ubicomplab/AuraRing/README.md

# AuraRing
Precise Electromagnetic Finger Tracking

AuraRing is 5-DoF electromagnetic tracker that enables precise, accurate, and fine-grained finger tracking for AR, VR and wearable applications.
