ubicomplab/AuraRing/pcb/wristBand_rx/ring_rx_v3_controller/ring_rx_v3_controller.xls

Line # | Name | Description | Designator | Quantity | Value | Manufacturer 1 | Manufacturer Part Number 1 | Manufacturer Lifecycle 1 | Supplier 1 | Supplier Part Number 1 | Supplier Unit Price 1 | Supplier Subtotal 1
 | Cap | Ceramic Capacitor (Surface Mount) | C3_c11, C3_c12, C3_c21, C3_c22, C3_c31, C3_c32 | 6 | 56nF | KEMET | C0402C563K9RACTU | Volume Production | Arrow | C0402C563K9RACTU | 0.3515 | 2.11
 | Cap | Ceramic Capacitor (Surface Mount) | C4_c11, C4_c12, C4_c21, C4_c22, C4_c31, C4_c32, C18_c11, C18_c12, C18_c21, C18_c22, C18_c31, C18_c32 | 12 | 10nF | Samsung | CL05B103KB5NNNC | Volume Production | Digi-Key | 1276-1028-1-ND | 0.024 | 0.288
 | Cap | Ceramic Capacitor (Surface Mount) | C5_c11, C5_c12, C5_c21, C5_c22, C5_c31, C5_c32, C8_c11, C8_c12, C8_c21, C8_c22, C8_c31, C8_c32, C16_c11, C16_c12, C16_c21, C16_c22, C16_c31, C16_c32 | 18 | 3.3nF | Yageo | CC0402JRX7R9BB332 | Volume Production | Mouser | 603-CC402JRX7R9BB332 | 0.028 | 0.504
 | Cap | Ceramic Capacitor (Surface Mount) | C9 | 1 | 1nF | Yageo | CC0402JRX7R9BB102 | Volume Production | Arrow | CC0402JRX7R9BB102 | 0.0102 | 0.0102
 | Cap | Ceramic Capacitor (Surface Mount) | C10, C13, C15, CU1, CU3, CU4_c11, CU4_c12, CU4_c21, CU4_c22, CU4_c31, CU4_c32 | 11 | 0.1uF | Samsung | CL05B104KO5NNNC | Volume Production | Digi-Key | 1276-1001-6-ND | 0.024 | 0.264
 | Cap | Ceramic Capacitor (Surface Mount) | C11, C12, C14 | 3 | 1uF | Samsung | CL05A105KP5NNNC | Volume Production | Arrow | CL05A105KP5NNNC | 0.0596 | 0.1788
 | Cap | Ceramic Capacitor (Surface Mount) | C17 | 1 | 470nF | Samsung | CL05A474KP5NNNC | Volume Production | Digi-Key | 1276-1173-6-ND | 0.1 | 0.1
 | Cap | Ceramic Capacitor (Surface Mount) | CU1-1, CU3-1 | 2 | 10uF | Murata | GRM155R60G106ME44D | Volume Production | Digi-Key | 490-10693-6-ND | 0.21 | 0.42
 | Cap | Ceramic Capacitor (Surface Mount) | CU?_U_coil_processing1, CU?_U_coil_processing2 | 2 | 2.2uF
 | TLMS1100-GS08 | LED, RED, 2.1 V, -40 to 100 degC, 2-Pin SMD (0603), RoHS, Tape and Reel | DS1, DS2 | 2 |  | Vishay | TLMS1100-GS08 | Volume Production | Mouser | 782-TLMS1100 | 0.4 | 0.8
 | 503480-1000 | 0.5 mm Pitch Easy-On(TM) BackFlip(TM) Type FPC Connector, 1.0 mm Mated Height, Right Angle, SMT, Dual Contact, 10 Circuits, -40 to 85 degC, ELV and RoHS Compliant, Tape and Reel | J1_U_coil_processing1, J1_U_coil_processing2 | 2 |  | Molex | 503480-1000 | Volume Production | Mouser | 538-503480-1000 | 0.84 | 1.68
 | MHDR1X4 | Header, 4-Pin | JTAG1 | 1 |  | Mill-Max | 851-43-004-10-001000 | Volume Production | Digi-Key | ED90528-ND | 1.43 | 1.43
 | Header 6H | Header, 6-Pin, Right Angle | P2 | 1 |  | Harwin | M20-9710646 | Volume Production | Digi-Key | 952-2372-ND | 0.26 | 0.26
 | Res | Chip Resistor (Surface Mount) | R3_c11, R3_c12, R3_c21, R3_c22, R3_c31, R3_c32, R6_c11, R6_c12, R6_c21, R6_c22, R6_c31, R6_c32 | 12 | 2k | Susumu | RR0510P-202-D | Volume Production | Arrow | RR0510P-202-D | 0.0409 | 0.4908
 | Res | Chip Resistor (Surface Mount) | R4_c11, R4_c12, R4_c21, R4_c22, R4_c31, R4_c32, R7_c11, R7_c12, R7_c21, R7_c22, R7_c31, R7_c32 | 12 | 1.33k | Yageo | RT0402BRD071K33L | Volume Production | Arrow | RT0402BRD071K33L | 0.2138 | 2.57
 | Res | Chip Resistor (Surface Mount) | R5 | 1 | 47k | Yageo | RC0402FR-0747KL | Volume Production | Arrow | RC0402FR-0747KL | 0.0011 | 0.0011
 | Res | Chip Resistor (Surface Mount) | R8_c11, R8_c12, R8_c21, R8_c22, R8_c31, R8_c32, R9_c11, R9_c12, R9_c21, R9_c22, R9_c31, R9_c32 | 12 | 3.92k | Stackpole Electronics | RMCF0402FT3K92 | Volume Production | Digi-Key | RMCF0402FT3K92DKR-ND | 0.016 | 0.192
 | Res | Chip Resistor (Surface Mount) | R10_c11, R10_c12, R10_c21, R10_c22, R10_c31, R10_c32, R11_c11, R11_c12, R11_c21, R11_c22, R11_c31, R11_c32 | 12 | 30.1 | Yageo | RT0402BRE0730R1L | Volume Production | Digi-Key | YAG4373DKR-ND | 0.303 | 3.64
 | Res | Chip Resistor (Surface Mount) | Rled1, Rled2 | 2 | 1k | Susumu | RR0510P-102-D | Volume Production | Arrow | RR0510P-102-D | 0.0943 | 0.1886
 | Res | Chip Resistor (Surface Mount) | Rr1 | 1 | 0 | Stackpole Electronics | RMCF0402ZT0R00 | Volume Production | Digi-Key | RMCF0402ZT0R00DKR-ND | 0.1 | 0.1
 | Res | Chip Resistor (Surface Mount) | Rr2 | 1 | DNP
 | MSP430FR2422 | MSP430FR2422 Mixed-Signal Microcontroller | U1 | 1 |  | Texas Instruments | MSP430FR2422IPW16 |  | Digi-Key | 296-48357-ND | 1.84 | 1.84
 | AD7265BCPZ-REEL7 | 1Dual 12-Bit SAR Analog-to-Digital Converter with Serial, SPI Interface, 1MSPS, -40 to +125 degC, CP-32-2, Pb-Free, Reel | U2 | 1 |  | Analog Devices | AD7265BCPZ-REEL7 | Volume Production | Arrow | AD7265BCPZ-REEL7 | 9.21 | 9.21
 | LTC6363 |  | U4_c11, U4_c12, U4_c21, U4_c22, U4_c31, U4_c32 | 6 |  | Analog Devices / Linear Technology | LTC6363IMS8#TRPBF | Not Recommended for New Design | Digi-Key | LTC6363IMS8#TRPBFDKR-ND | 6.2 | 37.2
 | ADA4084-1ARJZ-R7 | 30 V, 8 MHz, Low Bias Current, Single-Supply, RRO, Precision Op Amps | U9 | 1 |  |  |  |  | Digi-Key | ADA4084-1ARJZ-R7CT-ND
 | TPS70933 | 3.3V Ultra low power Voltage Regulator | U10 | 1 |  | Texas Instruments | TPS70933DBVT | Volume Production | Digi-Key | 296-39474-1-ND | 1.34 | 1.34
 | ADR3412ARJZ-R2 | Micropower, High Accuracy Voltage Reference, 1.2 V Output, 2.3 to 5.5 V Supply, Industrial, 6-pin SOT23 (RJ-6), Reel | U11 | 1 |  | Analog Devices | ADR3412ARJZ-R2 | Volume Production | Arrow | ADR3412ARJZ-R2 | 3.67 | 3.67
