ubicomplab/AuraRing/pcb/wristBand_rx/ring_rx_v3_sensor/ring_rx_v3_sensor.xls

Line # | Name | Description | Designator | Quantity | Value | Manufacturer 1 | Manufacturer Part Number 1 | Manufacturer Lifecycle 1 | Supplier 1 | Supplier Part Number 1 | Supplier Unit Price 1 | Supplier Subtotal 1
 | Cap | Ceramic Capacitor (Surface Mount) | C1_c1, C1_c2, C1_c3 | 3 | 2200pF | KEMET | C0402C222J3GACTU | Volume Production | Newark | 94M5623 | 0.563 | 1.69
 | Cap | Ceramic Capacitor (Surface Mount) | C2_c1, C2_c2, C2_c3 | 3 | 150pF | Kyocera AVX | 04025A151FAT2A | Volume Production | Digi-Key | 478-10089-6-ND | 0.36 | 1.08
 | Cap | Ceramic Capacitor (Surface Mount) | C6_c1, C6_c2, C6_c3, C7_c1, C7_c2, C7_c3 | 6 | 1nF | Yageo | CC0402JRX7R9BB102 | Volume Production | Arrow | CC0402JRX7R9BB102 | 0.0102 | 0.0612
 | Cap | Ceramic Capacitor (Surface Mount) | Cfilt1_c1, Cfilt1_c2, Cfilt1_c3 | 3 | 470pF | Samsung | CL05B471JB5NNNC | Volume Production | Arrow | CL05B471JB5NNNC | 0.0092 | 0.0276
 | Cap | Ceramic Capacitor (Surface Mount) | CU2_c1, CU2_c2, CU2_c3 | 3 | 0.1uF | Samsung | CL05B104KO5NNNC | Volume Production | Digi-Key | 1276-1001-6-ND | 0.024 | 0.24
 | 503480-1000 | 0.5 mm Pitch Easy-On(TM) BackFlip(TM) Type FPC Connector, 1.0 mm Mated Height, Right Angle, SMT, Dual Contact, 10 Circuits, -40 to 85 degC, ELV and RoHS Compliant, Tape and Reel | J1 | 1 |  | Molex | 503480-1000 | Volume Production | Mouser | 538-503480-1000 | 0.84 | 0.84
 | 3DC15 |  | L1 | 1 |  | Grupo Premo | 3DC15-1000J | Manual Solution | Grupo Premo | 3DC15-1000J | 5.73 | 5.73
 | Res | Chip Resistor (Surface Mount) | R1_c1, R1_c2, R1_c3, R2_c1, R2_c2, R2_c3 | 6 | 332k | Stackpole Electronics | RMCF0402FT332K | Volume Production | Digi-Key | RMCF0402FT332KDKR-ND | 0.016 | 0.16
 | SMS7630-040 |  | Rd1_c1, Rd1_c2, Rd1_c3, Rd2_c1, Rd2_c2, Rd2_c3, Rd3_c1, Rd3_c2, Rd3_c3, Rd4_c1, Rd4_c2, Rd4_c3 | 12 |  | Skyworks Solutions | SMS7630-040LF | Volume Production | Mouser | 873-SMS7630-040LF | 0.449 | 5.39
 | Res | Chip Resistor (Surface Mount) | Rg1_c1, Rg1_c2, Rg1_c3 | 3 | 100 | TE Connectivity | RN73C1E100RBTDF | Volume Production | Mouser | 279-RN73C1E100RBTDF | 0.9 | 2.7
 | INA826AIDRGT | Precision, 200-uA Supply Current, 36-V Supply Instrumentation Amplifier, -40 to 125 degC, 8-pin SON (DRG8), Green (RoHS & no Sb/Br) | U2_c1, U2_c2, U2_c3 | 3 |  | Texas Instruments | INA826AIDRGT | Volume Production | Arrow | INA826AIDRGT | 2.74 | 8.21
