ubicomplab/AuraRing/cad/ring/ring_20.STL

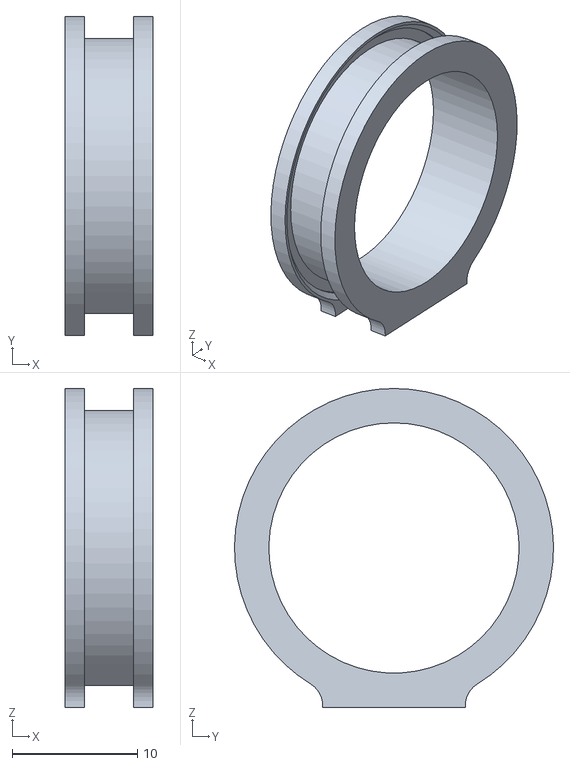
[picture p1: CAD file, 2020-01-06]
cad/ring/ring_20.STL
7.00 x 25.5 x 25.5
