ubicomplab/AuraRing/cad/wristband/wristband.STL

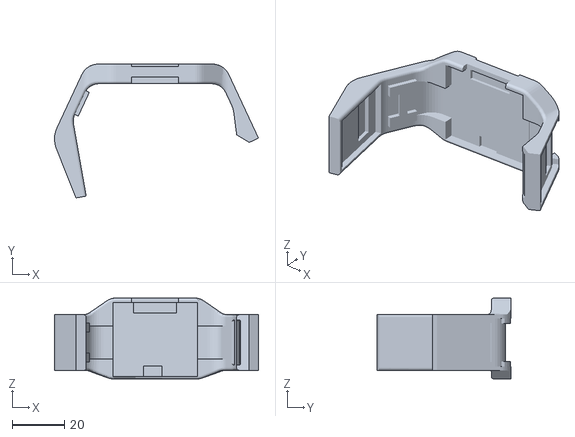
[picture p2: CAD file, 2020-01-06]
cad/wristband/wristband.STL
78.1 x 51.2 x 31.0
