ubicomplab/AuraRing/pcb/wristBand_rx/ring_rx_v3_sensor/ring_rx_v3_sensor.step

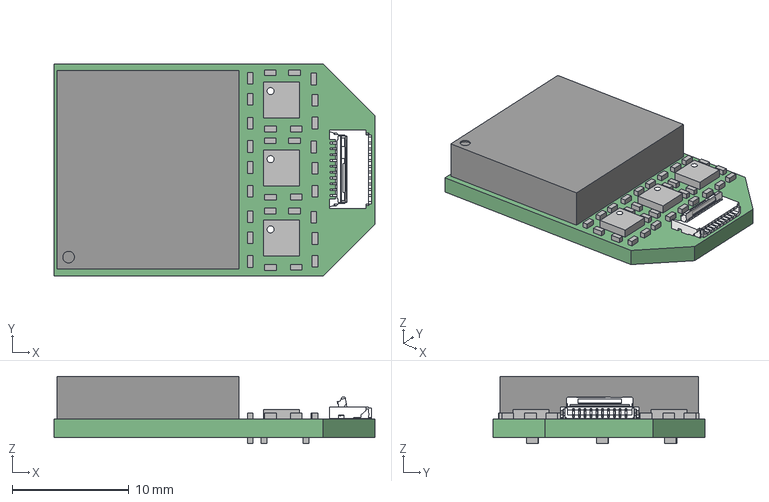
[picture p3: CAD file, 2019-12-18]
pcb/wristBand_rx/ring_rx_v3_sensor/ring_rx_v3_sensor.step
27.5 x 18.2 x 5.75 mm
