ubicomplab/AuraRing/cad/ring/tracking_adapter_22.STL

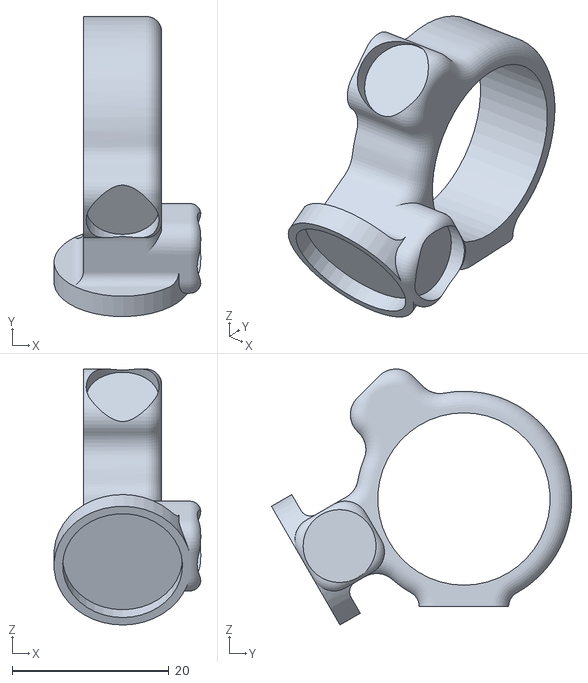
[picture p4: CAD file, 2020-01-06]
cad/ring/tracking_adapter_22.STL
18.7 x 38.3 x 32.7
