ubicomplab/AuraRing/cad/wristband/tracking_adapter.STL

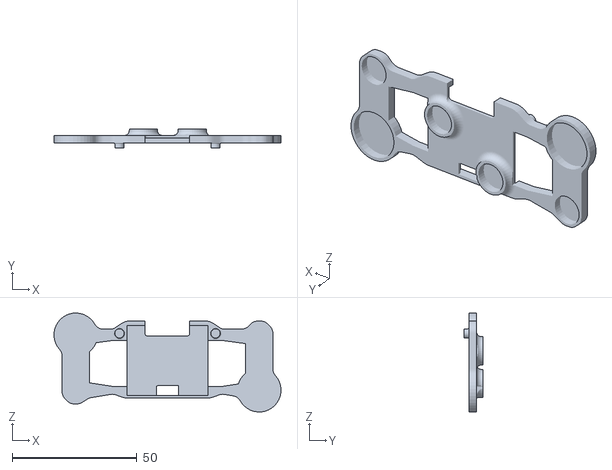
[picture p5: CAD file, 2020-01-06]
cad/wristband/tracking_adapter.STL
91.1 x 7.50 x 39.7
