ubicomplab/AuraRing/cad/ring/ring_inset_22.STL

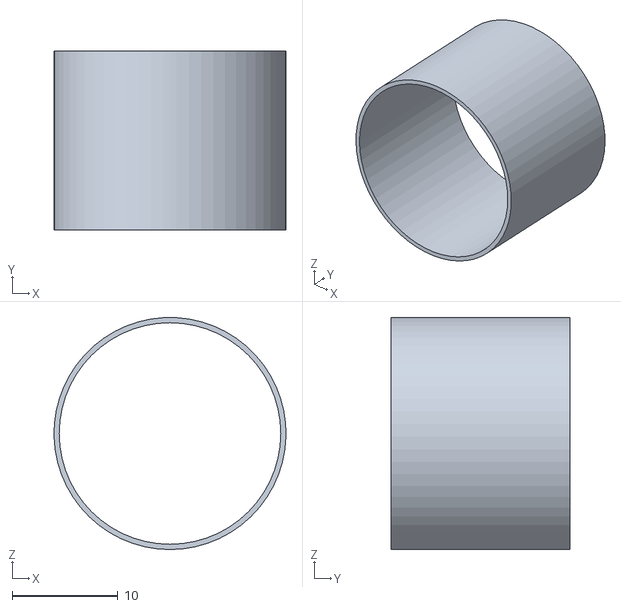
[picture p6: CAD file, 2020-01-06]
cad/ring/ring_inset_22.STL
22.0 x 17.0 x 22.0
