ubicomplab/AuraRing/cad/ring/ring_22.STL

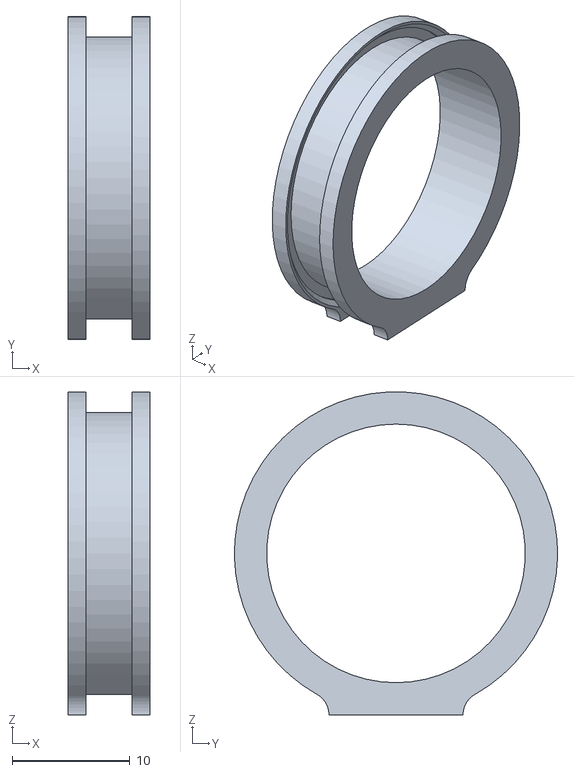
[picture p7: CAD file, 2020-01-06]
cad/ring/ring_22.STL
7.00 x 27.5 x 27.5
