ubicomplab/AuraRing/cad/ring/tracking_adapter_20.STL

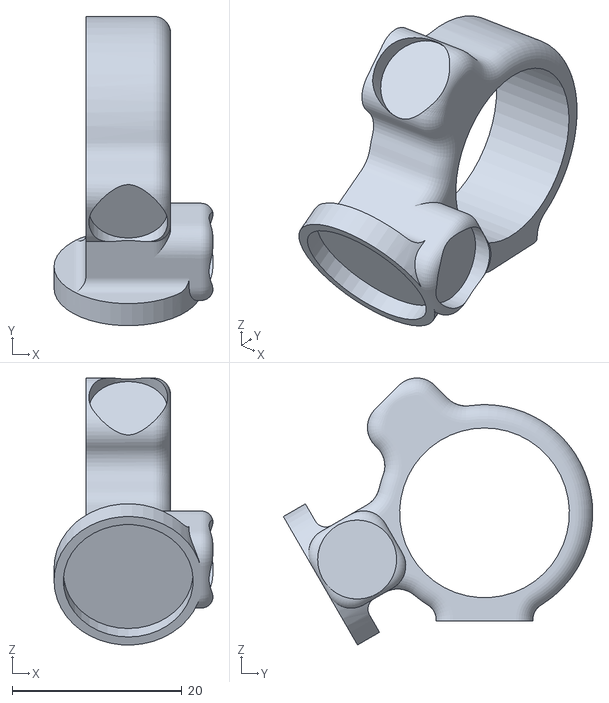
[picture p8: CAD file, 2020-01-06]
cad/ring/tracking_adapter_20.STL
18.7 x 36.5 x 31.5
