ubicomplab/AuraRing/cad/ring/ring_inset_20.STL

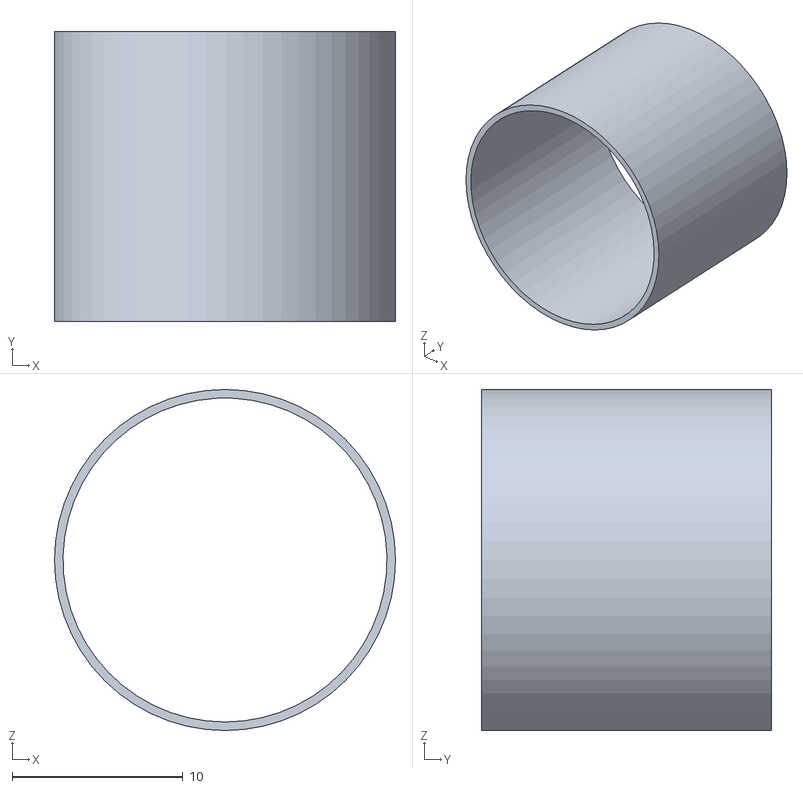
[picture p9: CAD file, 2020-01-06]
cad/ring/ring_inset_20.STL
20.0 x 17.0 x 20.0
