ubicomplab/AuraRing/(threads)

Thread 2 (2023-02-15):

specific Version of dependencis

Myzhencai, 2023-02-15:
Hi we just have make up the hardware and we have tried to compile the code of mag-inverse but we failed it seems that the version of the Eigen and the Ceres is wrong ,could you please sharing the specific Version of these dependences,thanks:-)
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

Myzhencai, 2023-02-15:
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
