ubicomplab/AuraRing/pcb/ring_tx/ring_v3.pdf

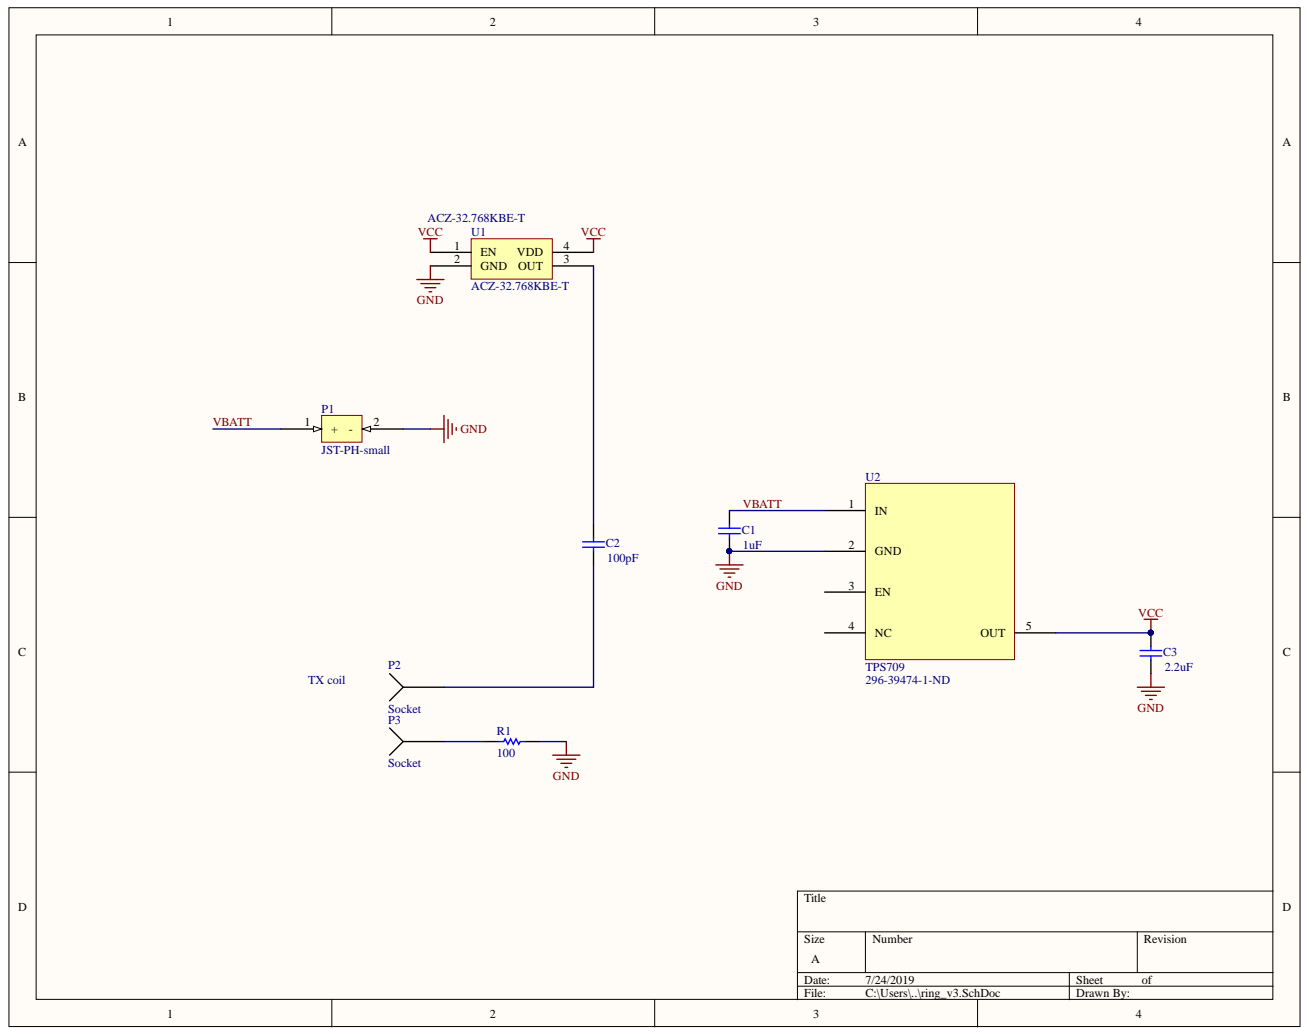
[picture p10: page 1]

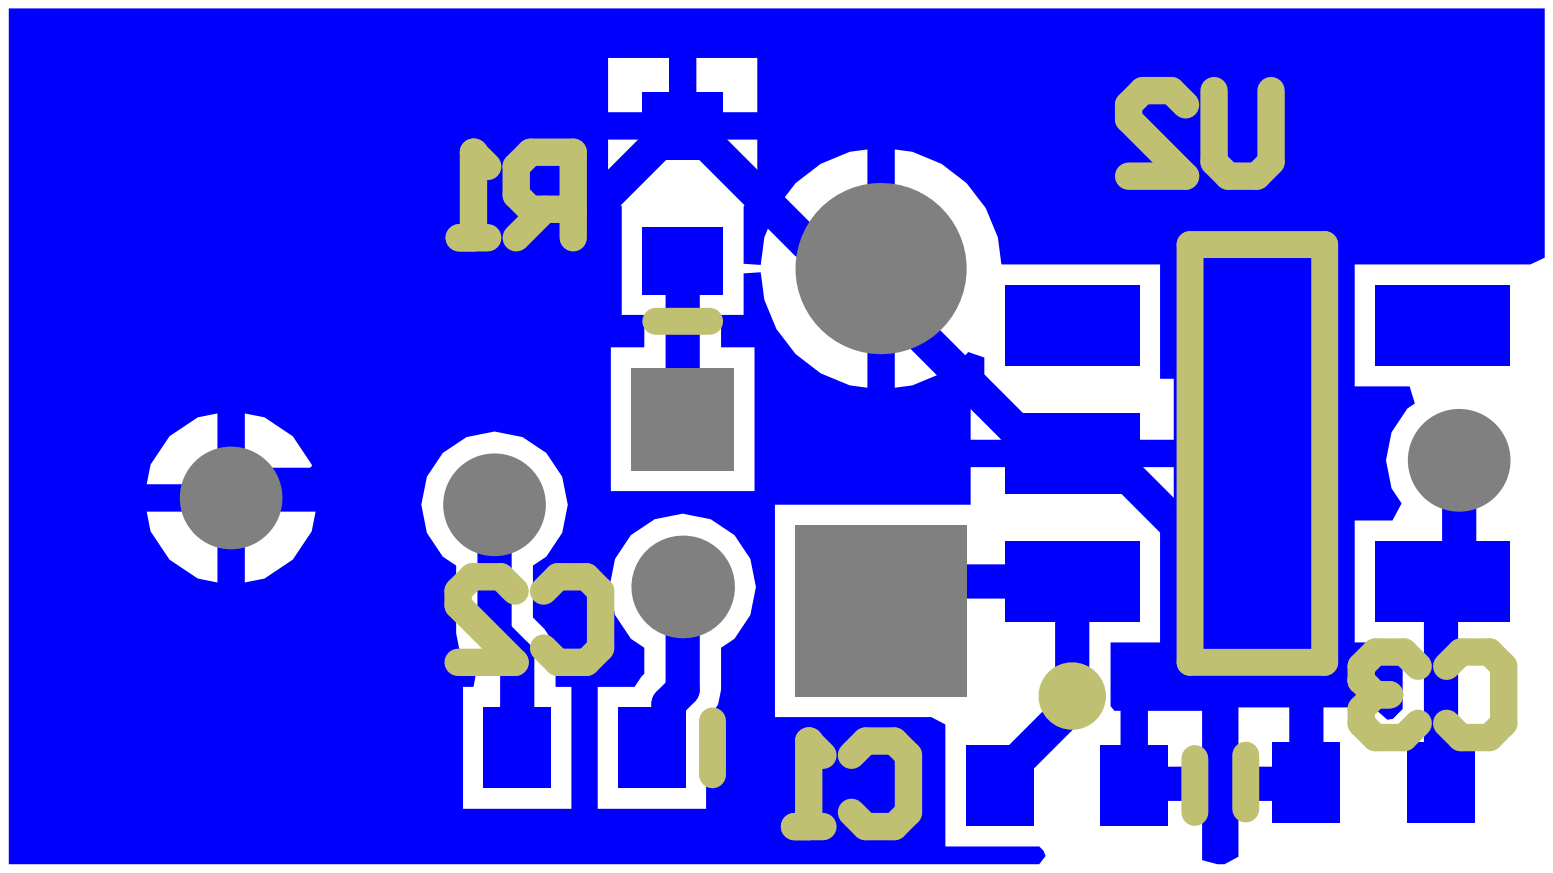
[picture p11: page 2]

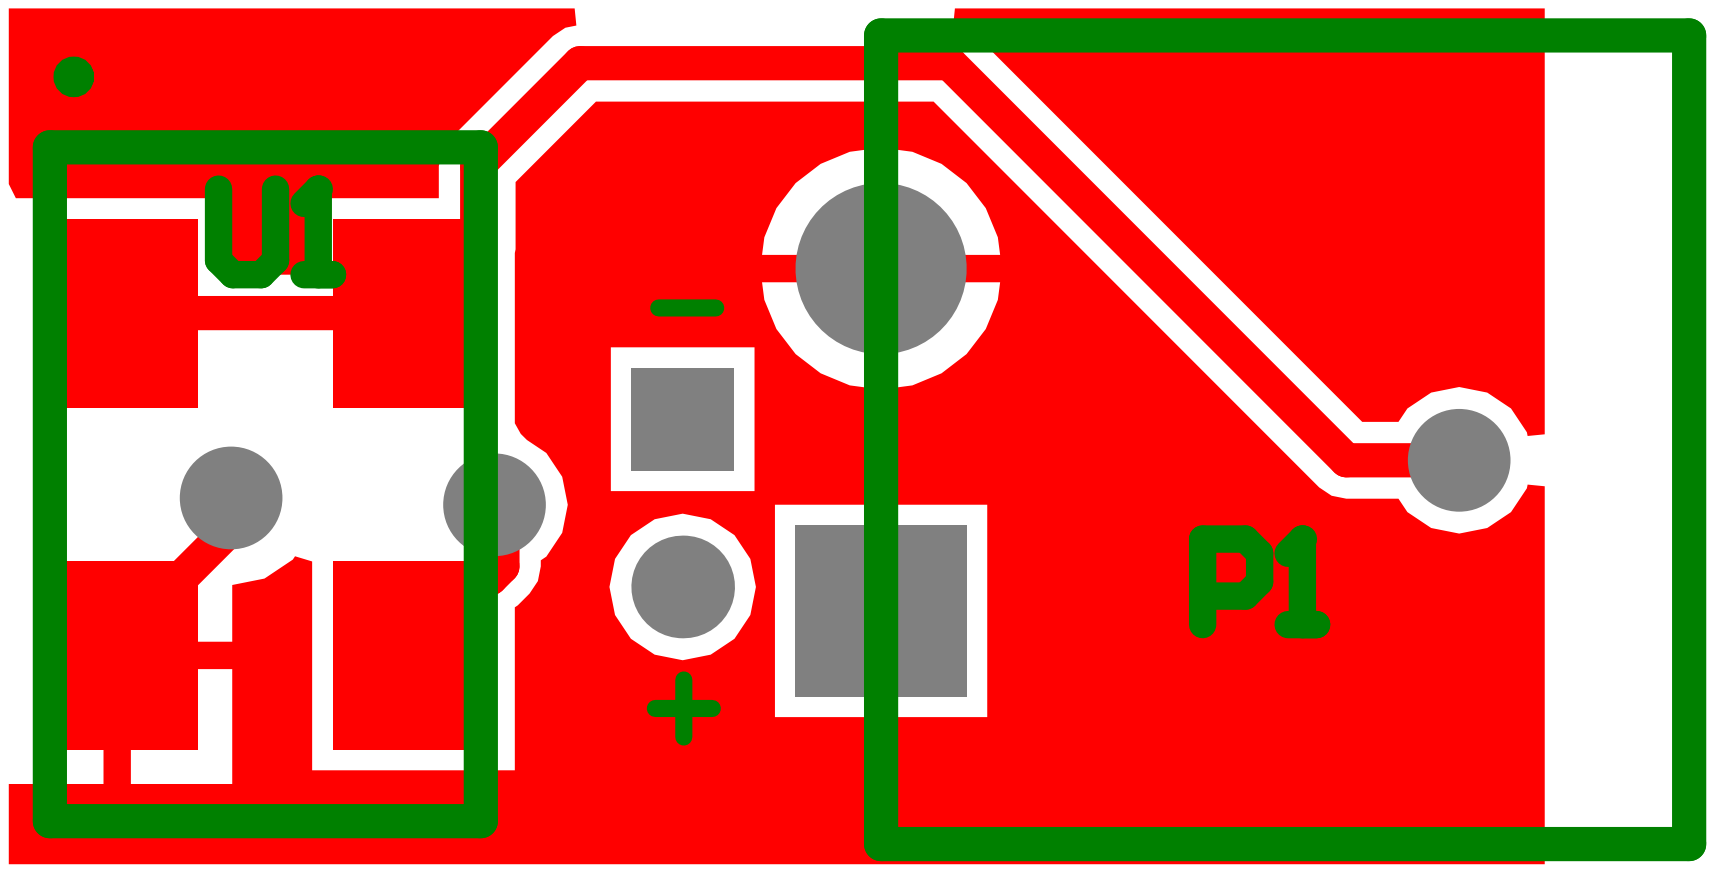
[picture p12: page 3]

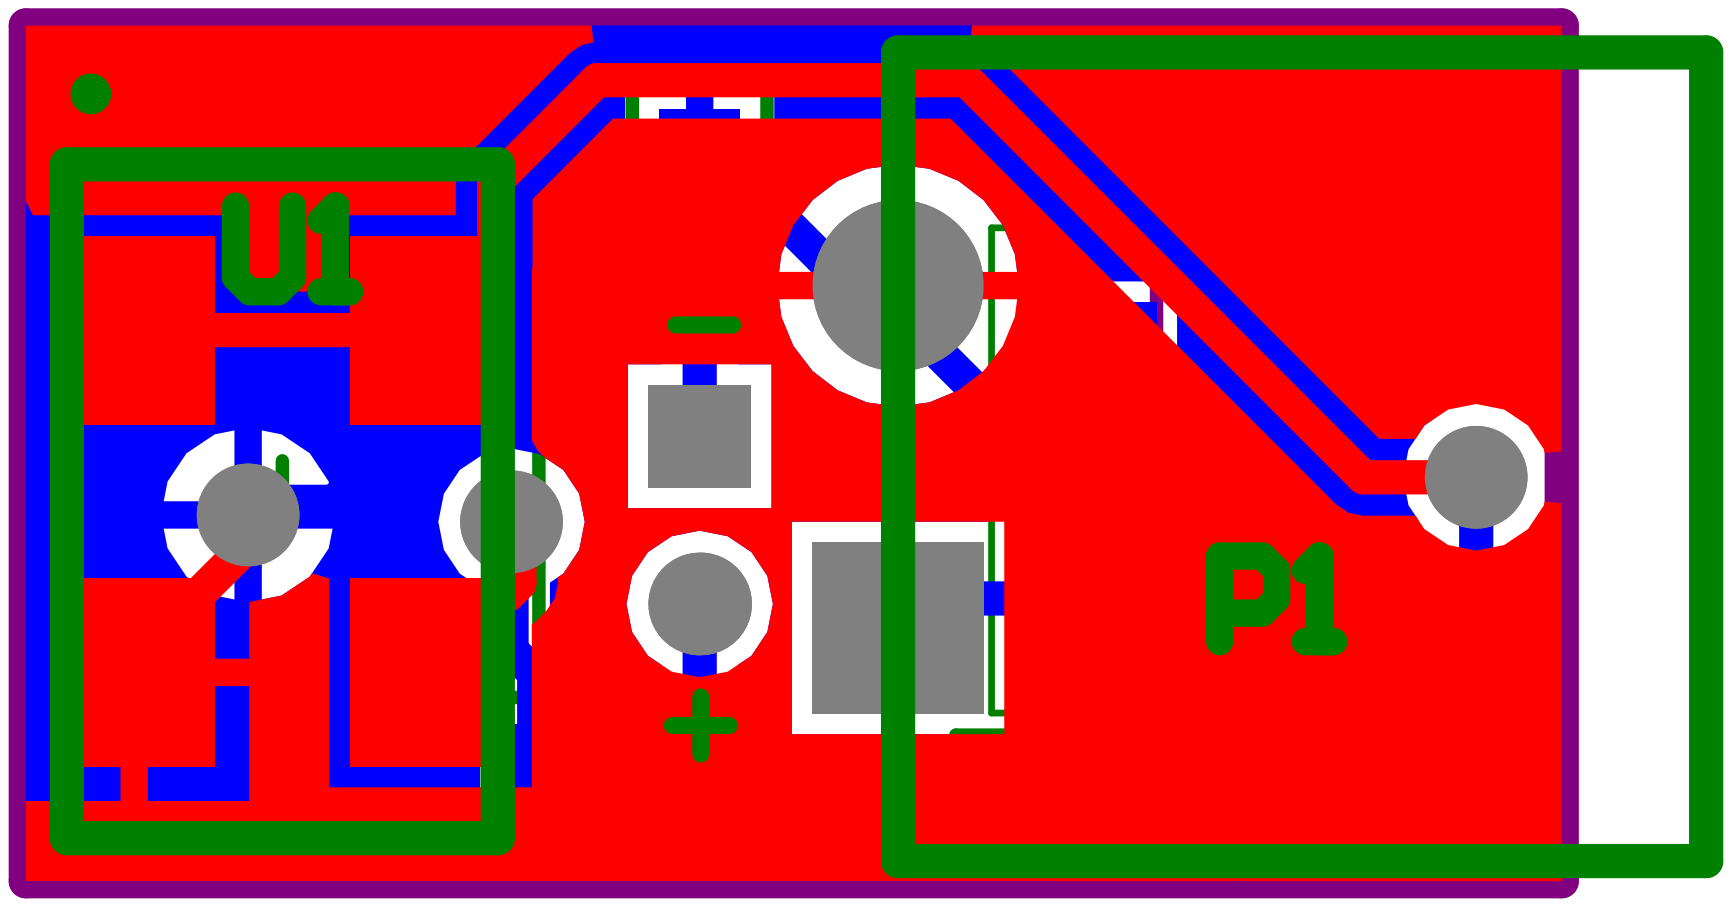
[picture p13: page 4]

Comment | Description | Designator | Footprint | LibRef | Quantity
Cap | Ceramic Capacitor (Surface Mount) C1 | | 402 | Cap | 1
Cap | Ceramic Capacitor (Surface Mount) C2 | | 402 | Cap | 1
Cap | Ceramic Capacitor (Surface Mount) C3 | | 402 | Cap | 1
JST-PH-small | | P1 | JST-PH-small | JST-PH-small | 1
Socket | | P2 | socket | Socket | 1
Socket | | P3 | socket | Socket | 1
Res | Chip Resistor (Surface Mount) R1 | | 402 | Res | 1
ACZ-32.768KBE-T | 32.768kHz XO (Standard) CMOS Oscillator 3.3V Enable/Disable 4-SMD, No Lead U1 | | ACZ-32.768KBE-T | ACZ-32.768KBE-T | 1
TPS709 | 3.3V Ultra low power Voltage Regulator U2 | | SOT95P280X145-5N | TPS70933 | 1
