ubicomplab/AuraRing/pcb/wristBand_rx/ring_rx_v3/assmblyDrawing.pdf

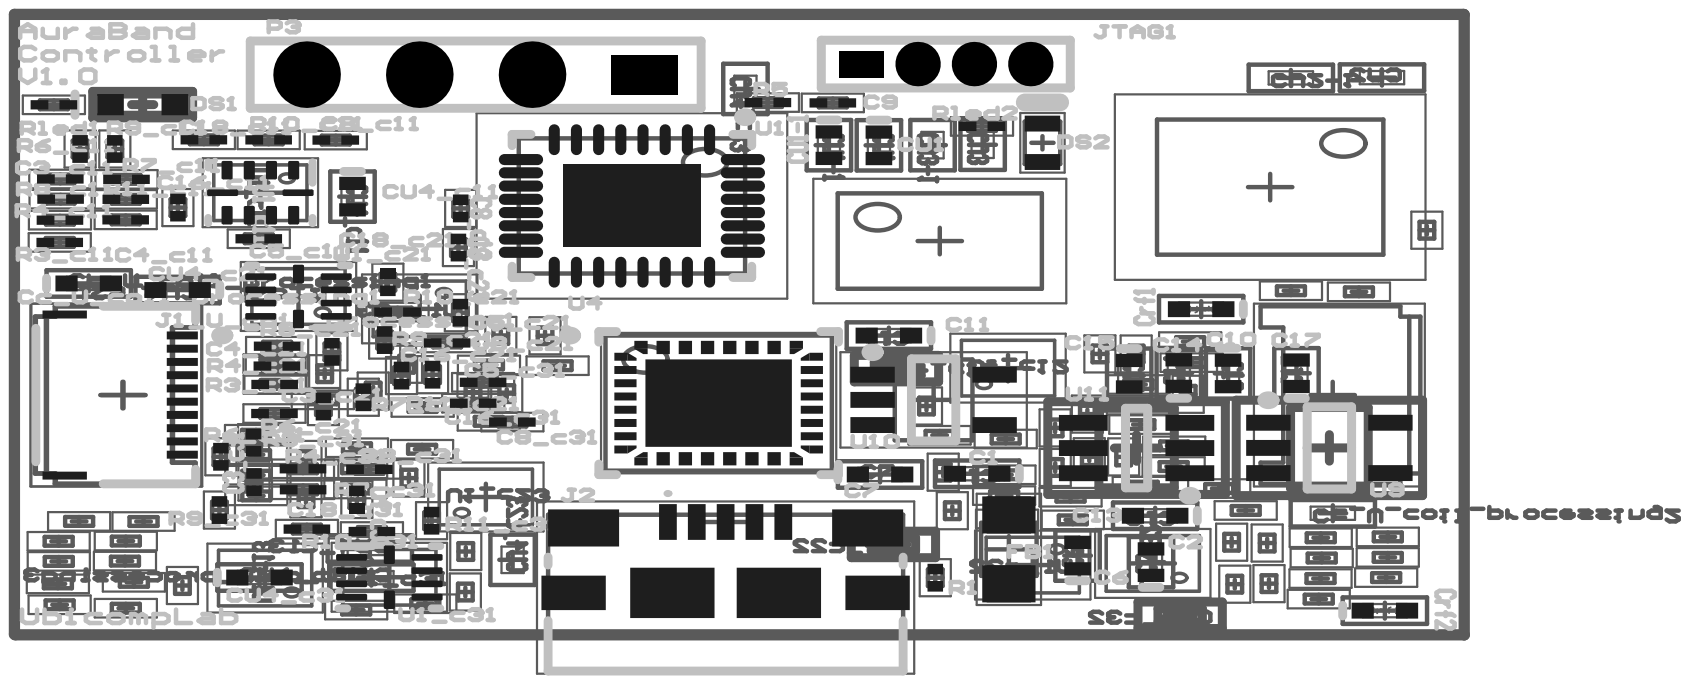
[picture p14: page 1]

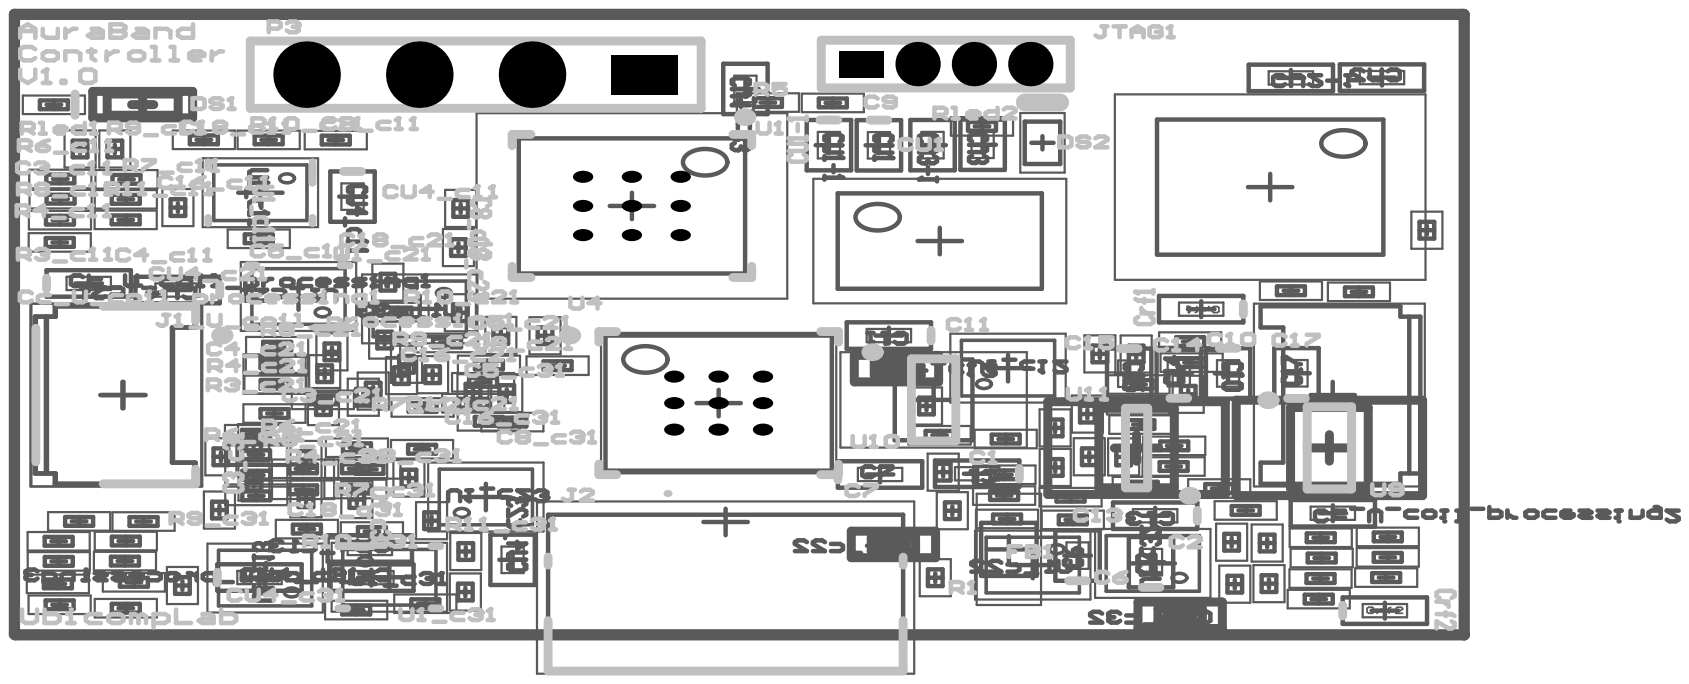
[picture p15: page 2]

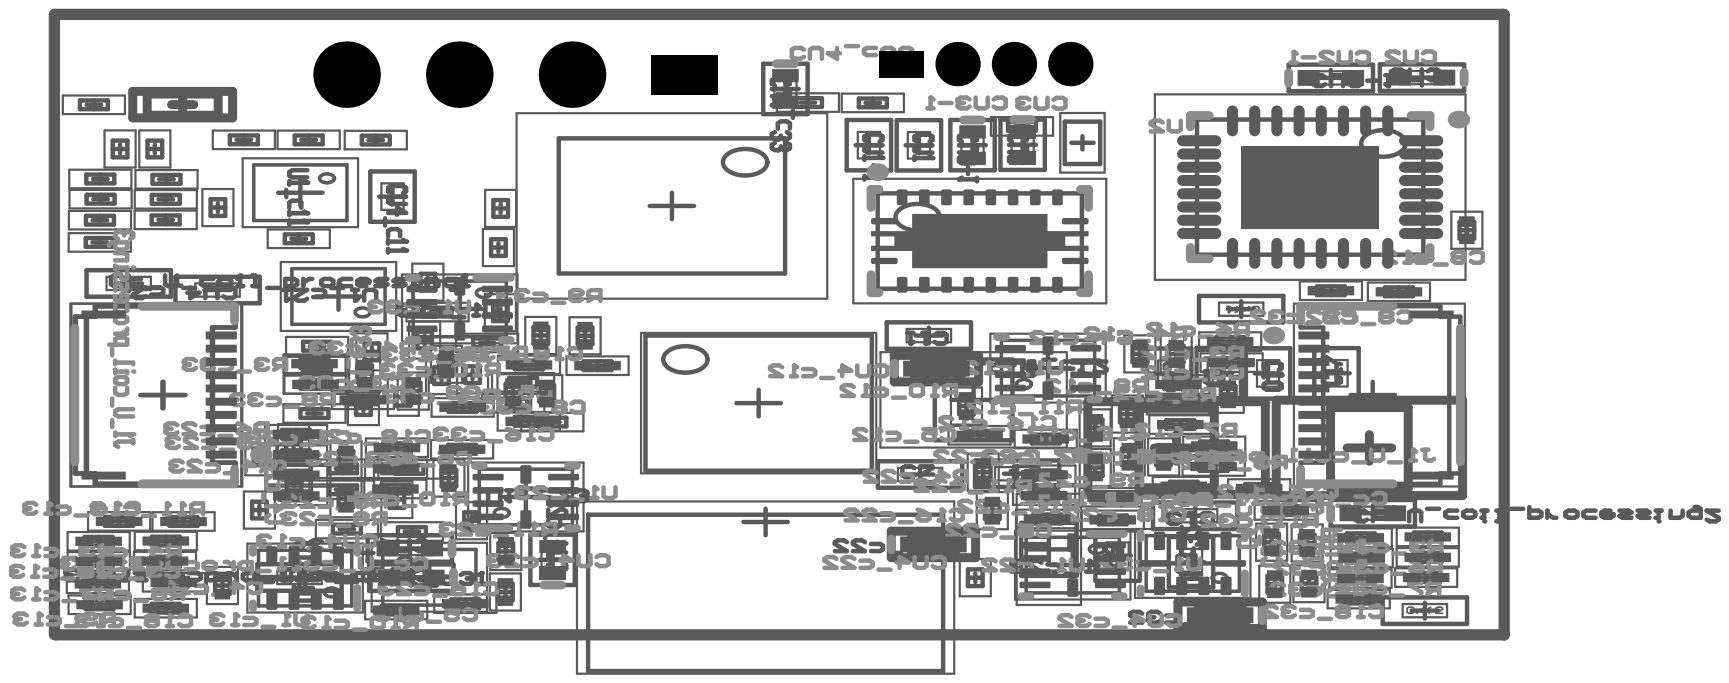
[picture p16: page 4]
