ubicomplab/AuraRing/pcb/wristBand_rx/ring_rx_v3_sensor/ring_rx_v3_sensor.pdf

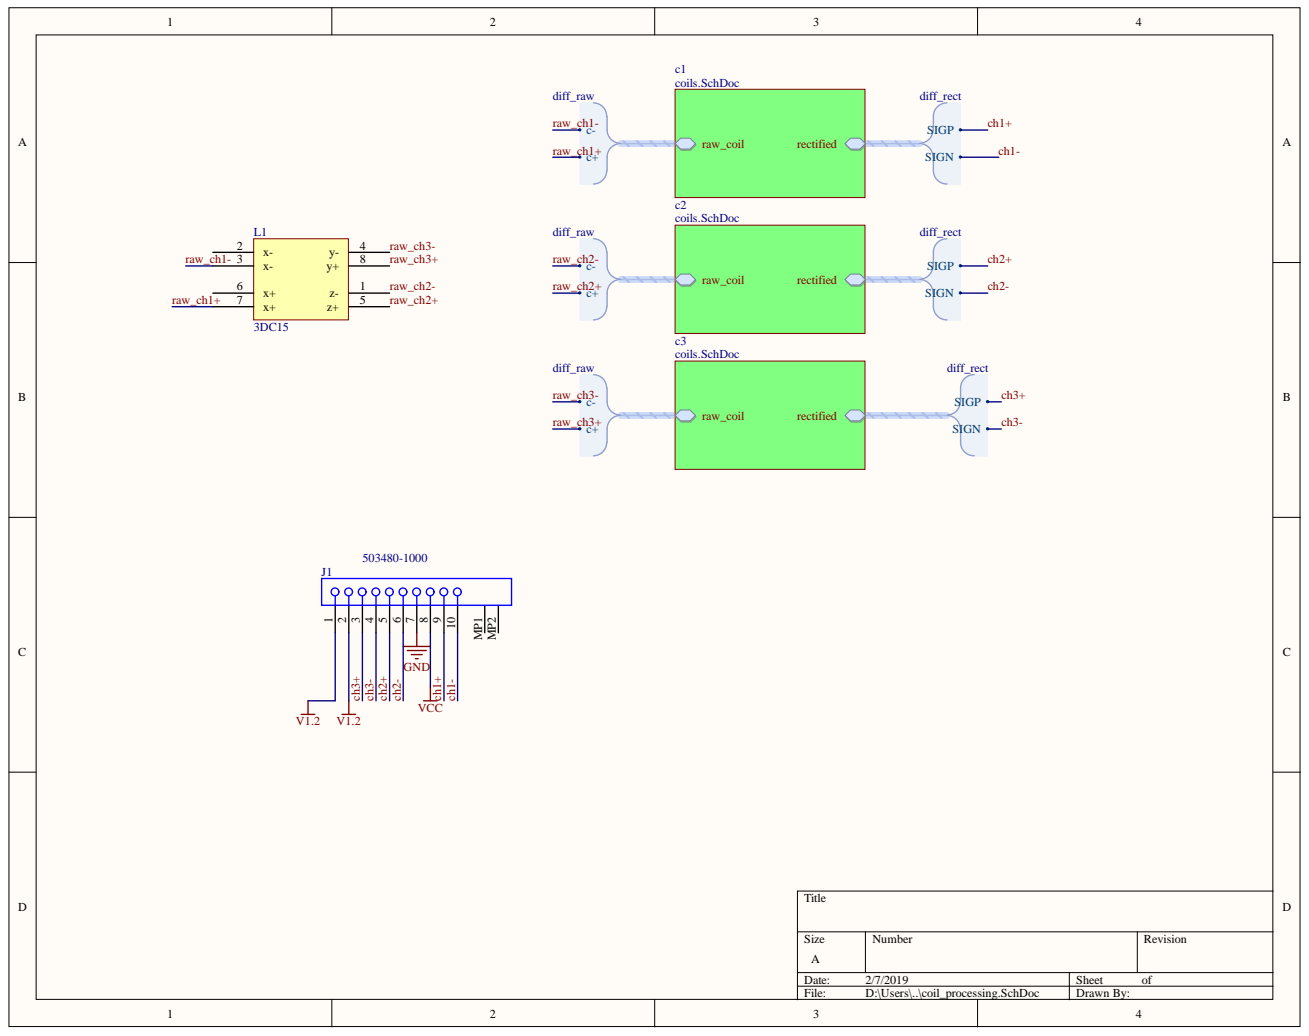
[picture p23: page 1]

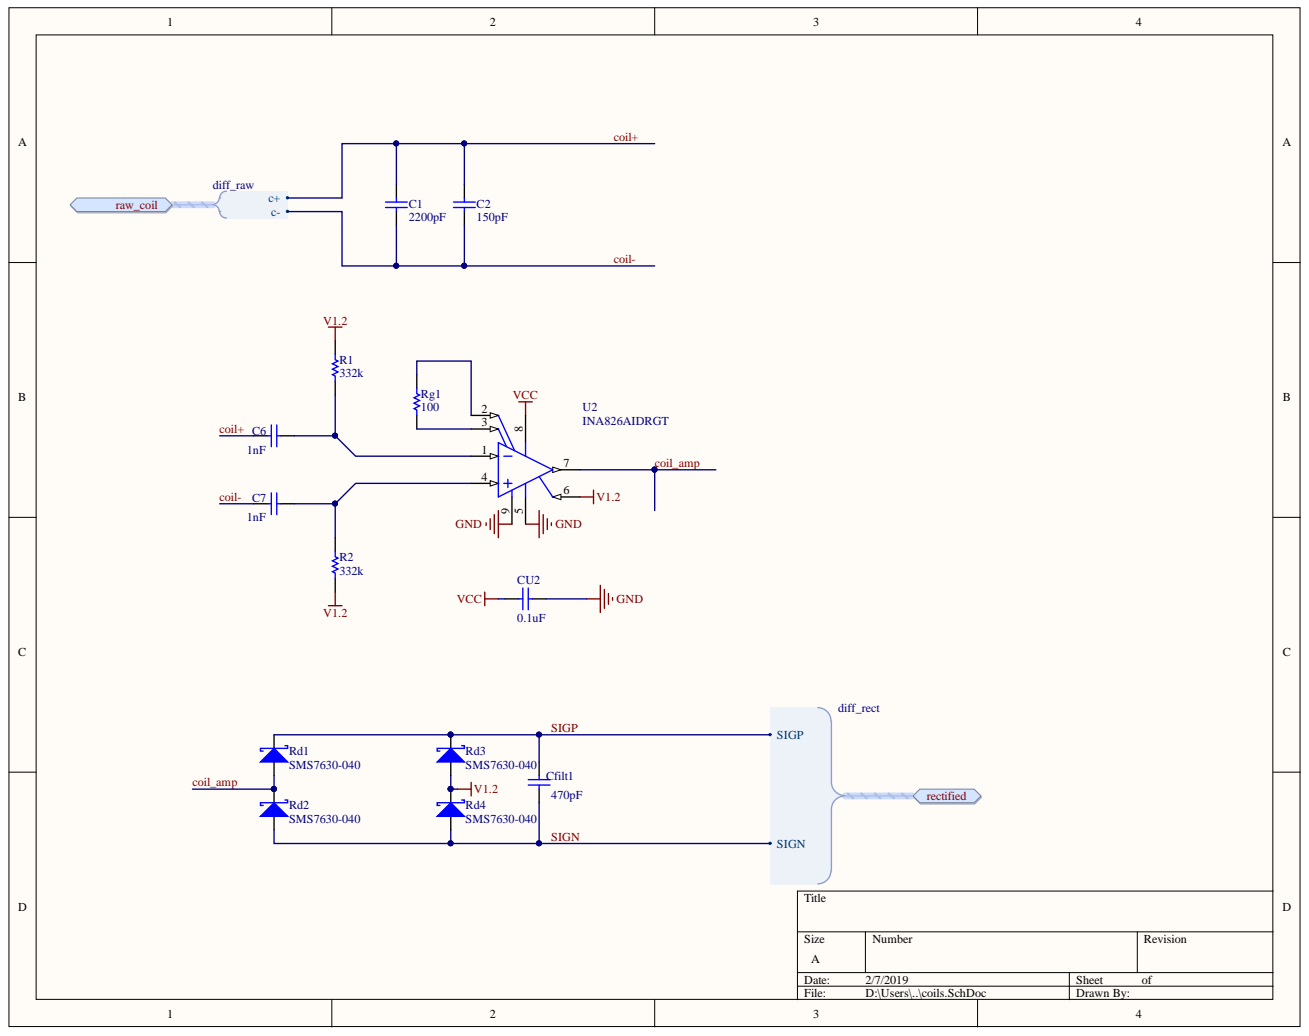
[picture p24: page 2]

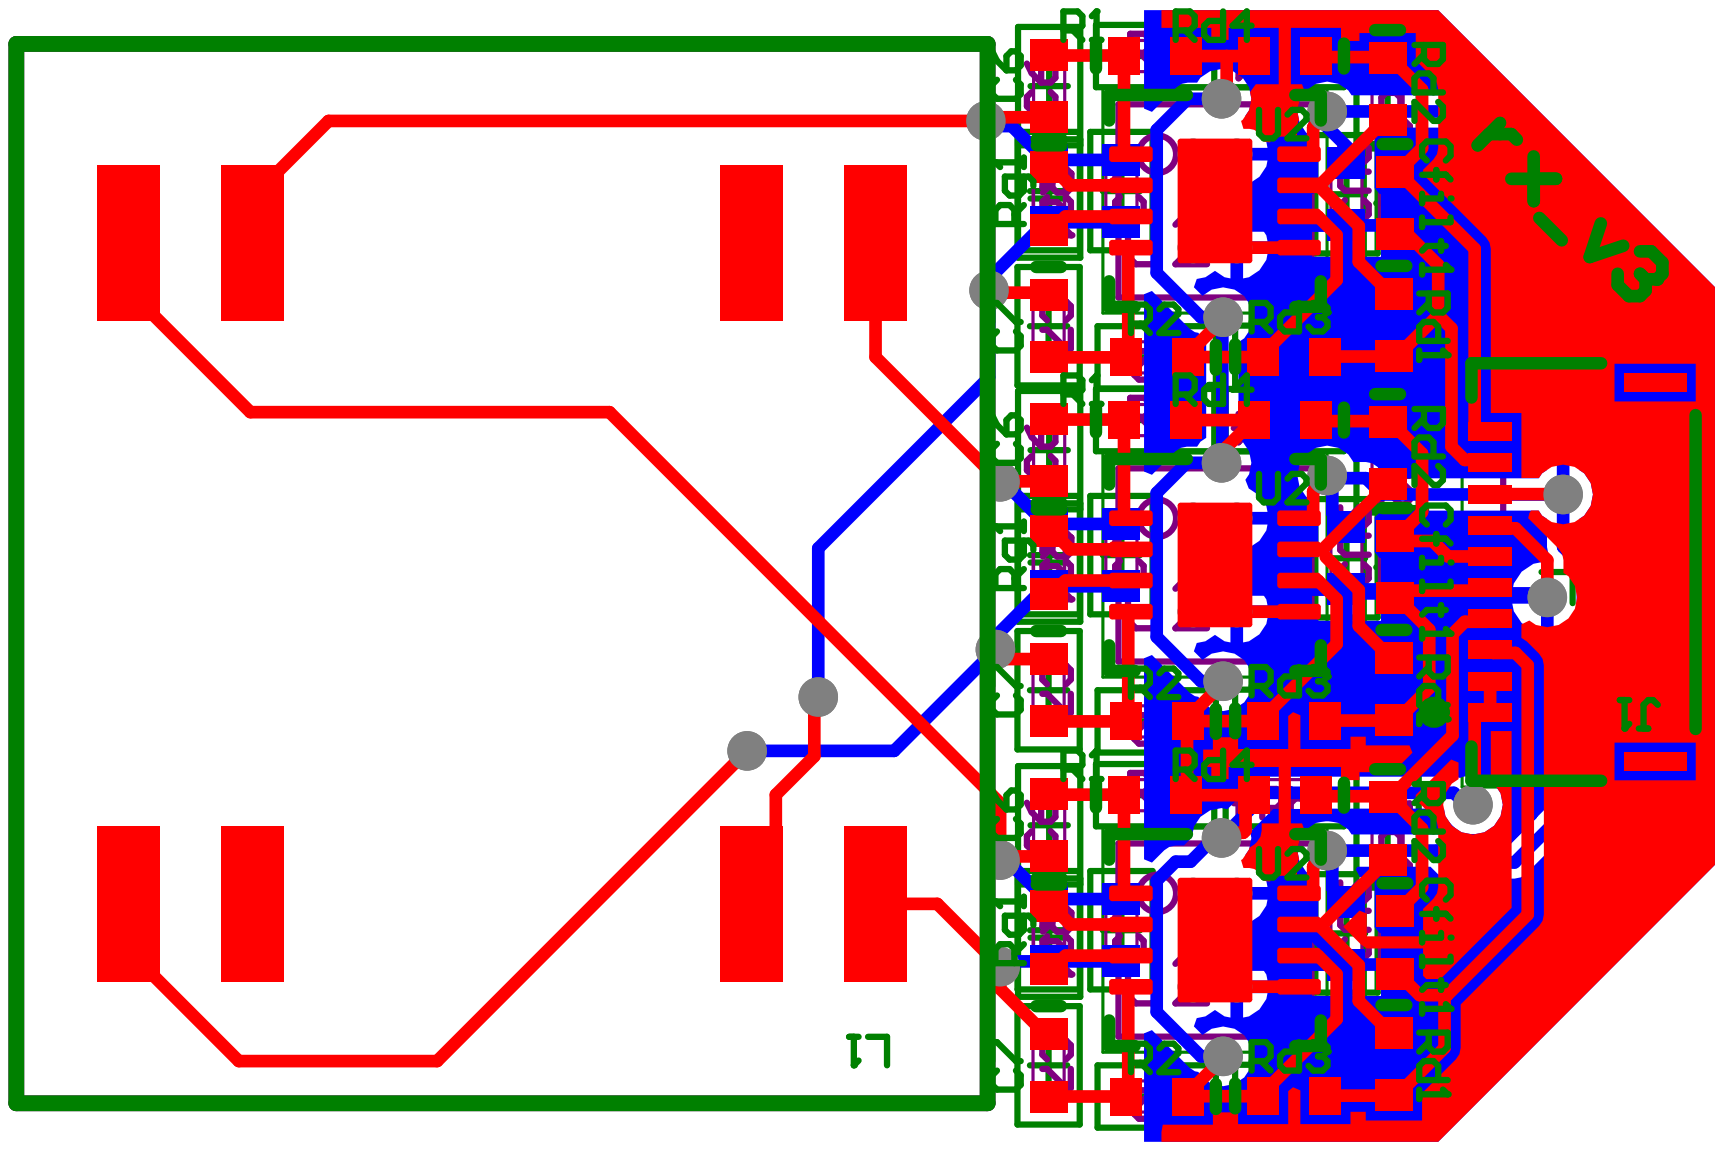
[picture p25: page 3]
