ubicomplab/AuraRing/(list of files, drawings)

Other design files:
pcb/ring_tx/ring_v3.PcbDoc
pcb/ring_tx/ring_v3.PrjPcb
pcb/ring_tx/ring_v3.SchDoc
pcb/wristBand_rx/ring_rx_v3_controller/coil_processing.SchDoc
pcb/wristBand_rx/ring_rx_v3_controller/coils.SchDoc
pcb/wristBand_rx/ring_rx_v3_controller/mcu.SchDoc
pcb/wristBand_rx/ring_rx_v3_controller/power.SchDoc
pcb/wristBand_rx/ring_rx_v3_controller/psoc.SchDoc
pcb/wristBand_rx/ring_rx_v3_controller/ring_rx_v3_controller.PcbDoc
pcb/wristBand_rx/ring_rx_v3_controller/ring_rx_v3_controller.PrjPcb
pcb/wristBand_rx/ring_rx_v3_controller/rx.SchDoc
pcb/wristBand_rx/ring_rx_v3_sensor/coil_processing.SchDoc
pcb/wristBand_rx/ring_rx_v3_sensor/coils.SchDoc
pcb/wristBand_rx/ring_rx_v3_sensor/ring_rx_v3_sensor.PcbDoc
pcb/wristBand_rx/ring_rx_v3_sensor/ring_rx_v3_sensor.PrjPcb
