ubicomplab/AuraRing/firmware/AuraRing-Rx-bottom/clock.c

/*
 * clock.c
 *
 *  Created on: Jan 18, 2019
 *      Author: farshid
 */
#include <driverlib.h>
#include <msp430.h>

void Software_Trim();                       // Software Trim to get the best DCOFTRIM value
#define MCLK_FREQ_MHZ 8                     // MCLK = 8MHz

void clock_init() {
    // Configure one FRAM waitstate as required by the device datasheet for MCLK
    // operation beyond 8MHz _before_ configuring the clock system.
    FRCTL0 = FRCTLPW | NWAITS_1;

    __bis_SR_register(SCG0);                           // disable FLL
    CSCTL3 |= SELREF__REFOCLK;                         // Set REFO as FLL reference source
    CSCTL0 = 0;                                        // clear DCO and MOD registers
    CSCTL1 &= ~(DCORSEL_7);                            // Clear DCO frequency select bits first
    CSCTL1 |= DCORSEL_5;                               // Set DCO = 16MHz
    CSCTL2 = FLLD_0 + 487;                             // DCOCLKDIV = 16MHz
    __delay_cycles(3);
    __bic_SR_register(SCG0);                           // enable FLL
    Software_Trim();                                   // Software Trim to get the best DCOFTRIM value
    while(CSCTL7 & (FLLUNLOCK0 | FLLUNLOCK1));         // FLL locked

    CSCTL4 = SELMS__DCOCLKDIV | SELA__REFOCLK;         // set default REFO(~32768Hz) as ACLK source, ACLK = 32768Hz
                                                       // default DCOCLKDIV as MCLK and SMCLK source, SMCLK = 16MHz
//    CSCTL5 = DIVM__2;                                  // Divide MCLK by 2, MCLK = 8MHz

//    __bis_SR_register(SCG0);                 // disable FLL
//    CSCTL3 |= SELREF__REFOCLK;               // Set REFO as FLL reference source
//    CSCTL0 = 0;                              // clear DCO and MOD registers
//    CSCTL1 &= ~(DCORSEL_7);                  // Clear DCO frequency select bits first
//    CSCTL1 |= DCORSEL_3;                     // Set DCO = 8MHz
//    CSCTL2 = FLLD_0 + 243;                   // DCODIV = 8MHz
//    __delay_cycles(3);
//    __bic_SR_register(SCG0);                 // enable FLL
//    Software_Trim();                                   // Software Trim to get the best DCOFTRIM value
//    while(CSCTL7 & (FLLUNLOCK0 | FLLUNLOCK1)); // Poll until FLL is locked
//
//    CSCTL4 = SELMS__DCOCLKDIV | SELA__REFOCLK; // set default REFO(~32768Hz) as ACLK source, ACLK = 32768Hz
//                                             // default DCODIV as MCLK and SMCLK source
//     Configure MCLK and SMCLK = 1MHz
//     ACLK is at 32,768kHz; Max 40kHz;CS_REFOCLK_SELECT=32.768kHz;CS_VLOCLK_SELECT=10kHz
//    DCORSEL = DCORSEL_5; /* 16 MHz */
//    CS_initClockSignal(CS_MCLK, CS_DCOCLKDIV_SELECT, CS_CLOCK_DIVIDER_1);
//    CS_initClockSignal(CS_SMCLK, CS_DCOCLKDIV_SELECT, CS_CLOCK_DIVIDER_1);
//    CS_initClockSignal(CS_ACLK, CS_REFOCLK_SELECT, CS_CLOCK_DIVIDER_1);
}


void Software_Trim()
{
    unsigned int oldDcoTap = 0xffff;
    unsigned int newDcoTap = 0xffff;
    unsigned int newDcoDelta = 0xffff;
    unsigned int bestDcoDelta = 0xffff;
    unsigned int csCtl0Copy = 0;
    unsigned int csCtl1Copy = 0;
    unsigned int csCtl0Read = 0;
    unsigned int csCtl1Read = 0;
    unsigned int dcoFreqTrim = 3;
    unsigned char endLoop = 0;

    do
    {
        CSCTL0 = 0x100;                         // DCO Tap = 256
        do
        {
            CSCTL7 &= ~DCOFFG;                  // Clear DCO fault flag
        }while (CSCTL7 & DCOFFG);               // Test DCO fault flag

        __delay_cycles((unsigned int)3000 * MCLK_FREQ_MHZ);// Wait FLL lock status (FLLUNLOCK) to be stable
                                                           // Suggest to wait 24 cycles of divided FLL reference clock
        while((CSCTL7 & (FLLUNLOCK0 | FLLUNLOCK1)) && ((CSCTL7 & DCOFFG) == 0));

        csCtl0Read = CSCTL0;                   // Read CSCTL0
        csCtl1Read = CSCTL1;                   // Read CSCTL1

        oldDcoTap = newDcoTap;                 // Record DCOTAP value of last time
        newDcoTap = csCtl0Read & 0x01ff;       // Get DCOTAP value of this time
        dcoFreqTrim = (csCtl1Read & 0x0070)>>4;// Get DCOFTRIM value

        if(newDcoTap < 256)                    // DCOTAP < 256
        {
            newDcoDelta = 256 - newDcoTap;     // Delta value between DCPTAP and 256
            if((oldDcoTap != 0xffff) && (oldDcoTap >= 256)) // DCOTAP cross 256
                endLoop = 1;                   // Stop while loop
            else
            {
                dcoFreqTrim--;
                CSCTL1 = (csCtl1Read & (~DCOFTRIM)) | (dcoFreqTrim<<4);
            }
        }
        else                                   // DCOTAP >= 256
        {
            newDcoDelta = newDcoTap - 256;     // Delta value between DCPTAP and 256
            if(oldDcoTap < 256)                // DCOTAP cross 256
                endLoop = 1;                   // Stop while loop
            else
            {
                dcoFreqTrim++;
                CSCTL1 = (csCtl1Read & (~DCOFTRIM)) | (dcoFreqTrim<<4);
            }
        }

        if(newDcoDelta < bestDcoDelta)         // Record DCOTAP closest to 256
        {
            csCtl0Copy = csCtl0Read;
            csCtl1Copy = csCtl1Read;
            bestDcoDelta = newDcoDelta;
        }

    }while(endLoop == 0);                      // Poll until endLoop == 1

    CSCTL0 = csCtl0Copy;                       // Reload locked DCOTAP
    CSCTL1 = csCtl1Copy;                       // Reload locked DCOFTRIM
    while(CSCTL7 & (FLLUNLOCK0 | FLLUNLOCK1)); // Poll until FLL is locked
}
