ubicomplab/AuraRing/firmware/AuraRing-Rx-bottom/timer.c

/*
 * timer.c
 *
 *  Created on: Jan 16, 2019
 *      Author: farshid
 */


#include <driverlib.h>
#include <msp430.h>

#define PERIOD 8

void timer_init() {
    //Start TIMER_A
    Timer_A_initUpModeParam initUpParam = {0};
    initUpParam.clockSource = TIMER_A_CLOCKSOURCE_SMCLK;
    initUpParam.clockSourceDivider = TIMER_A_CLOCKSOURCE_DIVIDER_1;
    initUpParam.timerPeriod = PERIOD;
    initUpParam.timerInterruptEnable_TAIE = TIMER_A_TAIE_INTERRUPT_DISABLE;
    initUpParam.timerClear = TIMER_A_DO_CLEAR;
    initUpParam.startTimer = false;
    Timer_A_initUpMode(TIMER_A0_BASE, &initUpParam);
}
