ubicomplab/AuraRing/(commit log)

2019-12-18 PCB files added
    [coil_processing.SchDoc, coils.SchDoc, mcu.SchDoc, power.SchDoc, psoc.SchDoc, ring_rx_v3_controller.PcbDoc, ring_rx_v3_controller.PrjPcb, ring_rx_v3_controller.xls]
2020-01-06 adding cad models
    [ring_20.STL, ring_22.STL, ring_inset_20.STL, ring_inset_22.STL, tracking_adapter.STL, tracking_adapter_20.STL, tracking_adapter_22.STL, wristband.STL]
